AndreasFMueller/Tracker/parts/bottom.scad

/*
 * bottom.scad -- bottom part of the electornics housing
 *
 * (c) 2015 Prof Dr Andreas Mueller, Hochschule Rapperswil
 */

include <electronics.scad>

bottom_part();
