AndreasFMueller/Tracker/(list of files, cad)

Other CAD files:
parts/button.scad
parts/top.scad
parts/Gear_with_Holes_Sample.scad
