AndreasFMueller/Tracker/hardware/tracker.kicad_pcb

## KiCad design hardware/tracker.kicad_pcb (2015-11-23)

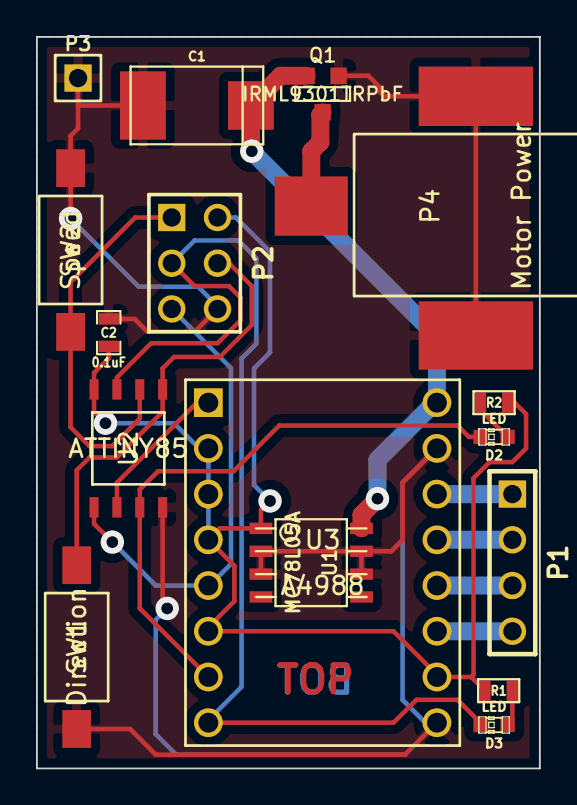
[picture p1: board tracker.kicad_pcb from above]

Board: 2 copper layers, 27.9 x 40.6 mm, 16 parts (0 on the bottom side), 16 nets.

Parts:
C1: 100u; c_tant_D
C2: 0.1uF; SM0603_Capa
D2, D3: LED; LED-0603
P1: Motor; PIN_ARRAY_4x1
P2: ISP; pin_array_3x2
P3: GND; PIN_ARRAY_1
P4: Motor Power; Power
Q1: IRML9301TRPbF; SOT23GDS
R1: 470; SM0603
R2: 1k; SM0603
SW1: Direction; FSM-SM
SW2: Speed; FSM-SM
U1: MC78L05A; so-8
U2: ATTINY85; SOIC8W
U3: A4988

Connections:
+5V: C2.1, P2.2, R1.1, R2.1, U1.1, U2.8, U3.2, U3.3, U3.4, U3.6, U3.10
+12V: C1.1, Q1.S, U1.8, U3.16
GND: C1.2, C2.2, P2.6, P3.1, P4.2, Q1.G, SW1.2, SW2.2, U1.2, U1.3, U1.6, U1.7, U2.4, U3.9, U3.15
unnamed: P2.5, U2.1, U3.5
unnamed: P4.1, Q1.D
unnamed: D3.2, P2.3, U2.7, U3.8
unnamed: P2.4, SW1.1, U2.5
unnamed: U2.2, U3.1
unnamed: P2.1, SW2.1, U2.6
unnamed: D3.1, R1.2
unnamed: D2.2, U2.3, U3.7
unnamed: D2.1, R2.2
unnamed: P1.4, U3.11
unnamed: P1.1, U3.14
unnamed: P1.2, U3.13
unnamed: P1.3, U3.12
