AndreasFMueller/Tracker/(commit log)

2015-08-08 add parts and software skeleton
    [Gear_Double_Helical.scad, Gear_Grub.scad, Gear_with_Grub_Sample.scad, Gear_with_Holes_Sample.scad, bottom.scad, button.scad, electronics.scad, housing.scad]
2015-08-08 add hardware files
    [tracker.sch]
2015-08-13 add missing pcb file
    [tracker.kicad_pcb]
2015-08-13 add new plastic parts
    [electronics.scad, spacerring.scad, stencil.scad]
2015-11-17 improve documentation, fix PWM configuration (:-0)
    [electronics.scad]
2015-11-20 fix repeat command bug
    [timer.c]
2015-11-22 turn of LED when timer is stopped
2015-11-23 no timer output at startup
2015-11-23 move LED2 to STEP output
    [tracker.kicad_pcb, tracker.sch]
